zzvllvzz/binaryWatch/hardware/BOM_Board1_PCB1_2026-04-22.xlsx

No. | Quantity | Comment | Designator | Footprint | Value | Manufacturer Part | Manufacturer | Supplier Part | Supplier | Unique ID | Name | LCSC Price | JLCPCB Price
1 | 1 | 100nF | C24 | C0402 | 100nF | CL05B104KO5NNNC | SAMSUNG(三星) | C1525 | LCSC | gge36 | 100nF |  | 0.0002
2 | 5 | 10uF | C26,C27,C28,C29,C32 | C0402 | 10uF | CL05A106MP5NUNC | SAMSUNG(三星) | C315248 | LCSC | gge47,gge48,gge50,gge51,gge51_1 | 10uF |  | 0.0014
3 | 1 | 1uF | C30 | C0402 | 1uF | CL05B104KO5NNNC | SAMSUNG(三星) |  | LCSC | gge36_1 | 1uF
4 | 1 | 0.1uF | C31 | C0402 | 0.1uF | CL05B104KO5NNNC | SAMSUNG(三星) |  | LCSC | gge36_2 | 0.1uF
5 | 1 | 1uF | C33 | C0402 | 1uF | CL05A106MP5NUNC | SAMSUNG(三星) |  | LCSC | gge51_2 | 1uF
6 | 1 | B2B-PH-K-S(LF)(SN) | CN1 | CONN-TH_B2B-PH-K-S |  | B2B-PH-K-S(LF)(SN) | JST | C131337 | LCSC | gge1 | B2B-PH-K-S(LF)(SN) |  | 0.0049
7 | 1 | RB521S30T1G-DW | D4 | SOD-523_L1.2-W0.8-LS1.6-RD |  | RB521S30T1G-DW | DOWO(东沃) | C27636108 | LCSC | gge8 | RB521S30T1G-DW |  | 0.0019
8 | 1 | BAT760-7 | D5 | SOD-323_L1.7-W1.3-LS2.6-FD-1 |  | BAT760-7 | DOWO(东沃) | C27636120 | LCSC | gge12 | BAT760-7 |  | 0.0026
9 | 1 | LESD5D5.0CT1G | D6 | SOD-523_L1.2-W0.8-LS1.6-BI |  | LESD5D5.0CT1G | LRC(乐山无线电) | C383211 | LCSC | gge17 | LESD5D5.0CT1G |  | 0.0036
10 | 1 | HDR-F_2.54_2x3 | H1 | HDR-TH_6P-P2.54-V-F-R2-C3-S2.54 |  |  |  |  |  | gge62 |  | 0.5399
11 | 1 | KT-0805R | LED4 | LED0805-R-RD |  | KT-0805R | KENTO | C2295 | LCSC | gge5 | KT-0805R |  | 0.0013
12 | 1 | NCD0805R1 | LED6 | LED0805-R-RD |  | NCD0805R1 | 国星光电 | C84256 | LCSC | gge38 | NCD0805R1 |  | 0.002
13 | 4 | KT-0805G | LED8,LED9,LED10,LED11 | LED0805-R-RD |  | KT-0805G | KENTO | C2297 | LCSC | gge52,gge52_1,gge52_2,gge52_3 | KT-0805G |  | 0.0024
14 | 1 | AO3401 | Q6 | SOT-23-3_L2.9-W1.3-P0.95-LS2.4-BR |  | AO3401 | KUU | C2985640 | LCSC | gge10 | AO3401 |  | 0.0038
15 | 1 | 3kΩ | R16 | R0603 | 3kΩ | 0603WAF3001T5E | UNI-ROYAL(厚声) | C4211 | LCSC | gge3 | 3kΩ |  | 0.0003
16 | 2 | 1kΩ | R17,R18 | R0603 | 1kΩ | RC0603FR-071KL | YAGEO(国巨) | C22548 | LCSC | gge4,gge6 | 1kΩ |  | 0.0003
17 | 1 | 100kΩ | R19 | R0603 | 100kΩ | 0603WAF1003T5E | UNI-ROYAL(厚声) | C25803 | LCSC | gge9 | 100kΩ |  | 0.0003
18 | 2 | 22Ω | R20,R21 | R0603 | 22Ω | 0603WAF1003T5E | UNI-ROYAL(厚声) |  | LCSC | gge9_1,gge9_2 | 22Ω
19 | 2 | 10K | R22,R23 | R0603 | 10K |  |  |  |  | gge55,gge56 | 10K | 0.5399
20 | 4 | 5.1kΩ | R29,R32,R33,R34 | R0402 | 5.1kΩ | 0402WGF5101TCE | UNI-ROYAL(厚声) | C25905 | LCSC | gge34,gge34_1,gge34_2,gge34_3 | 5.1kΩ |  | 0.0002
21 | 1 | 560Ω | R31 | R0402 | 560Ω | 0402WGF5600TCE | UNI-ROYAL(厚声) | C25126 | LCSC | gge39 | 560Ω |  | 0.0002
22 | 3 | SKQGAFE010 | SW1,SW2,SW3 | SW-SMD_4P-L5.2-W5.2-P3.70-LS6.4 |  | SKQGAFE010 | ALPSALPINE(阿尔卑斯阿尔派) | C202424 | LCSC | gge57,gge58,gge59 | SKQGAFE010 |  | 0.0203
23 | 1 | UK-H0827G15-SP-Y | SW5 | SW-SMD_UK-H0827G15-SP-Y |  | UK-H0827G15-SP-Y | USAKRO(美韩) | C493292 | LCSC | gge60 | UK-H0827G15-SP-Y |  | 0.014
24 | 1 | MCP73831T-2ACI/OT | U4 | SOT-23-5_L3.0-W1.7-P0.95-LS2.8-BL |  | MCP73831T-2ACI/OT | MICROCHIP(美国微芯) | C424093 | LCSC | gge2 | MCP73831T-2ACI/OT |  | 0.1096
25 | 1 | ME6217C33M5G | U5 | SOT-23-5_L3.0-W1.7-P0.95-LS2.8-BR |  | ME6217C33M5G | MICRONE(南京微盟) | C427602 | LCSC | gge7 | ME6217C33M5G |  | 0.0116
26 | 1 | ATMEGA32U4-MU | U6 | VQFN-44_L7.0-W7.0-P0.50-BL-EP5.2 |  | ATMEGA32U4-MU | MICROCHIP(美国微芯) | C112161 | LCSC | gge53 | ATMEGA32U4-MU |  | 0.8174
27 | 1 | DS3231MZ+TRL | U7 | SOIC-8_L4.9-W3.9-P1.27-LS6.0-BL |  | DS3231MZ+TRL | ADI(亚德诺)/MAXIM(美信) | C107410 | LCSC | gge54 | DS3231MZ+TRL |  | 0.4519
28 | 1 | 1050170001 | USB1 | MICRO-USB-SMD_105017-0001 |  | 1050170001 | MOLEX | C136000 | LCSC | gge16 | 1050170001 |  | 0.0575
29 | 1 | 8MHz | X1 | OSC-SMD_3P-L3.2-W1.3-P1.20-L | 8MHz | CSTNE8M00GH5C000R0 | muRata(村田) | C341525 | LCSC | gge61 | 8MHz |  | 0.0313
