zzvllvzz/binaryWatch/hardware/binaryWatch.pdf

# LiPo CHARGER USB CONNECTOR

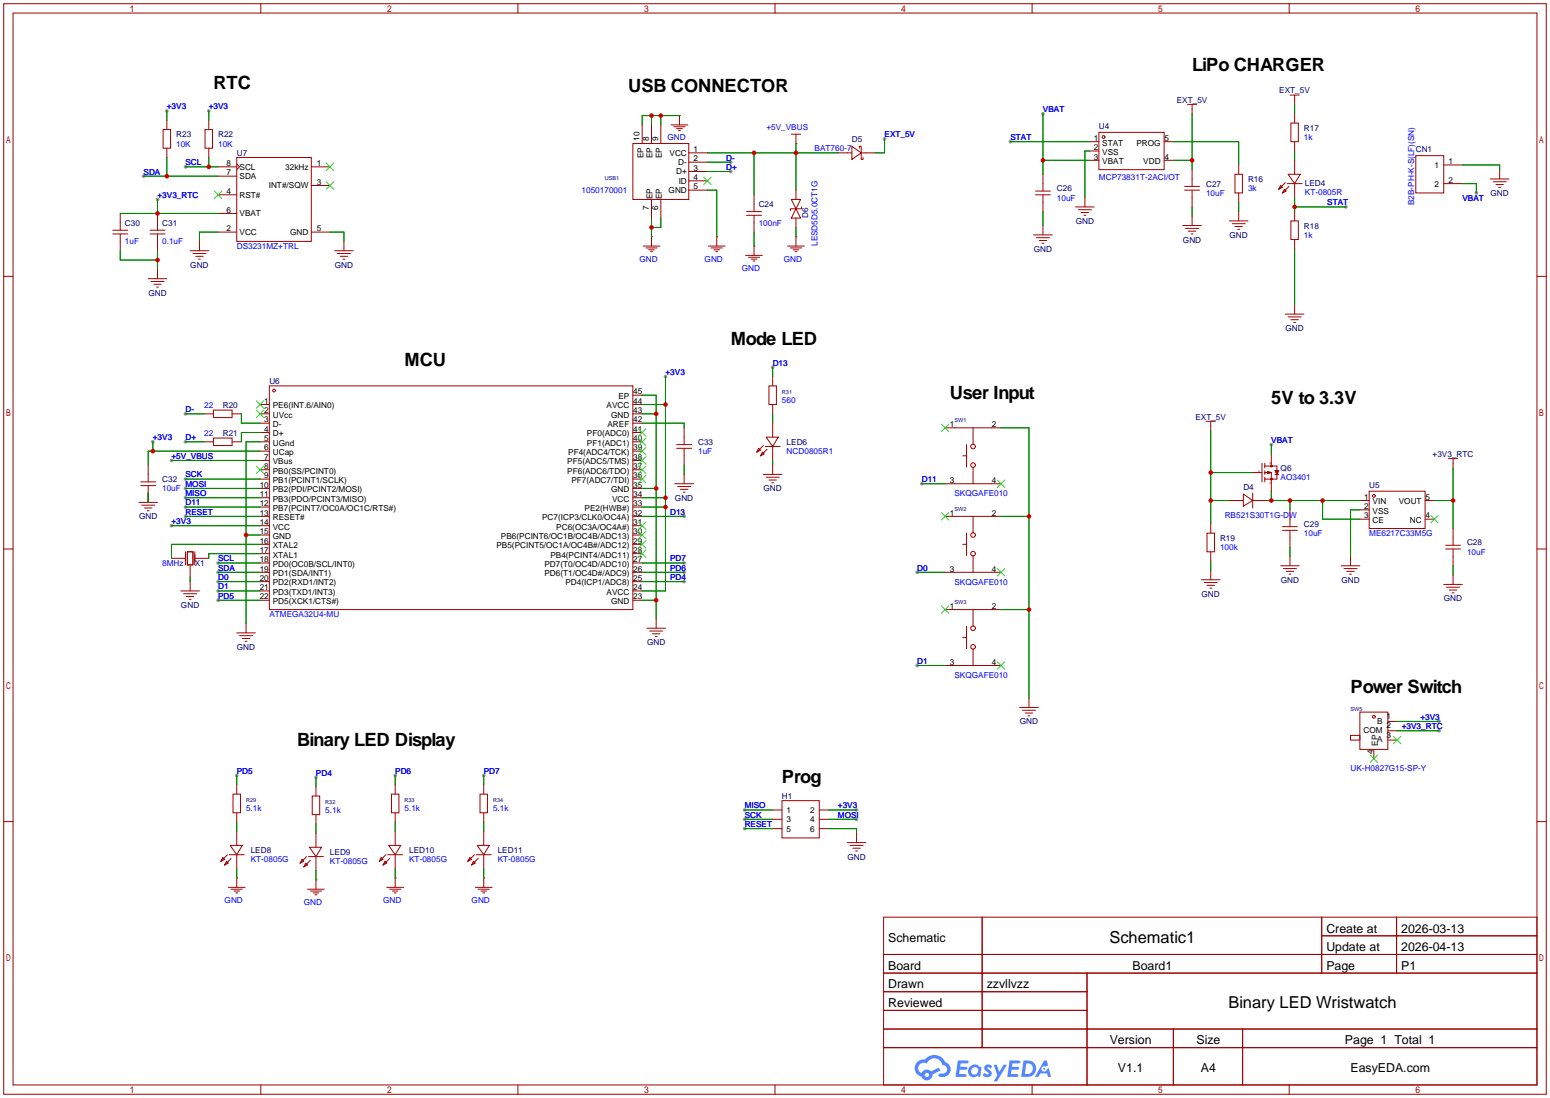
[picture p2: page 1]

Schematic | Schematic1 | Create at | 2026-03-13

Update at | 2026-04-13

Board | Board1 | Page | P1
Drawn | zzvllvzz | Binary LED Wristwatch
Reviewed

Version | Size | Page 1 Total 1
V1.1 | A4 | EasyEDA.com
