zzvllvzz/binaryWatch/(list of files, drawings)

Other design files:
hardware/ProDoc_Schematic1_2026-04-23.epro
