zzvllvzz/binaryWatch/(commit log)

2026-04-21 fix(files): add gerber, PnP and BOM. Rewrite readme.md
    [BOM_Board1_PCB1_2026-04-22.xlsx, PickAndPlace_PCB1_2026-04-22.xlsx]
2026-04-22 fix(files): add .eepro schematics and jpg of the wristwatch
    [ProDoc_Schematic1_2026-04-23.epro]
